precision-sustainable-ag/IRT/README.md

# IRT

## **InfraRed Thermometer Water/Heat Stress Sensing Project - 2019 Summary**  
Rebecca Hartman, Francis Santiago, Patricia Gonzalez-Medina

### Sensors
IRT Sensors from Melexis MLX90614 product line

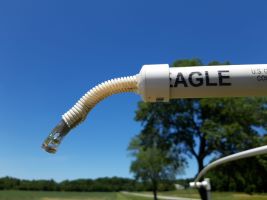
[picture p1: Images/Canopy_Small.jpg]
Canopy Sensor

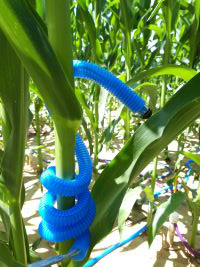
[picture p2: Images/Leaf Sensor_Small.jpg]
Leaf Sensor

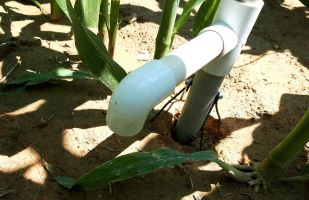
[picture p3: Images/Soil Sensor_Small.jpg]
Soil Sensor


**Canopy** - 90° FOV, **Leaf** - 35° FOV, **Soil** - 35° FOV

### Structure
PVC structure uses rotation instead of translation to adjust height of canopy sensor

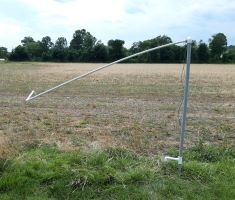
[picture p4: Images/Structure_Small.jpg]
Structure


### Boards
Components: MoteinoMEGA with LoRa transceiver, DS3231 RTC, microSD (Server only), custom PCBs

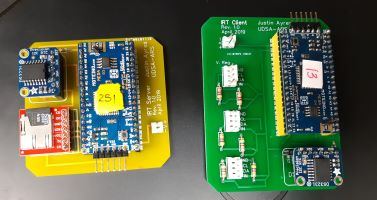
[picture p5: Images/Client Server_Small.jpg]
Client & Server


**Client:** collects data from sensors, saves to Flash, send data to Server
**Server:** receives data from Servers, saves data to microSD

### Power

Components: 12V SLA Batteries, 12V 3W Solar panels, Charge controller, Battery box

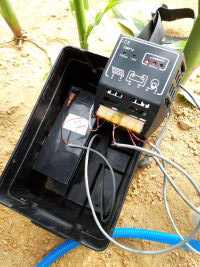
[picture p6: Images/Battery Charger_Small.jpg]
Battery & Controller

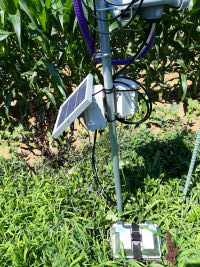
[picture p7: Images/Power Setup_Small.jpg]
Power Setup
