precision-sustainable-ag/IRT/Analysis/Epoxy_Potting Info.docx

- 2 part epoxy we currently have: https://www.jbweld.com/pages/faqs
- A bunch of different epoxies (website from Harry): https://www.electrolube.com/products/thermally-conductive-potting-compounds.html
- These 2 seem like the same glue: http://www.murraypercival.com/product/13948/electrolube-thermally-conductive-epoxy-resins-250g

And

http://www.murraypercival.com/product/13408/er2183-epoxy-resin-pack-thermal-conductivity-250g-black
