precision-sustainable-ag/IRT/Analysis/General Project Ideas.docx

- This guy used these IRT sensors outdoors and had to waterproof them:

https://blog.stevemarple.co.uk/2013/05/cloud-detector-first-data.html

- This is a cable gland like he used, and others have used:

https://www.google.com/search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

- Another application of cable glands/these sensors:

https://sciencedocbox.com/Weather/73594155-Arduino-weather-station-and-ascom-observing-conditions.html
