precision-sustainable-ag/IRT/Images/Client.jpg

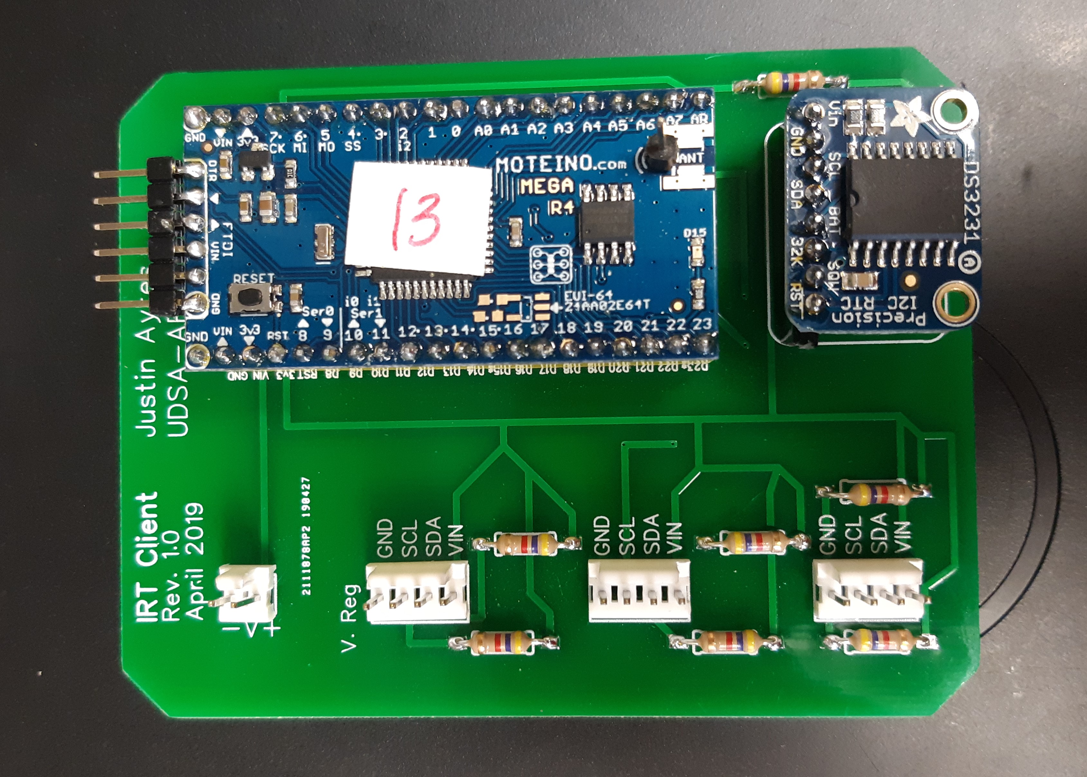
Images/Client.jpg
