precision-sustainable-ag/IRT/Images/Melexis IRT.jpg

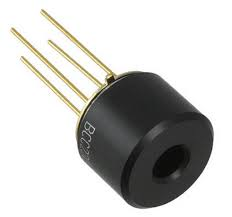
Images/Melexis IRT.jpg
