precision-sustainable-ag/IRT/Images/Server.jpg

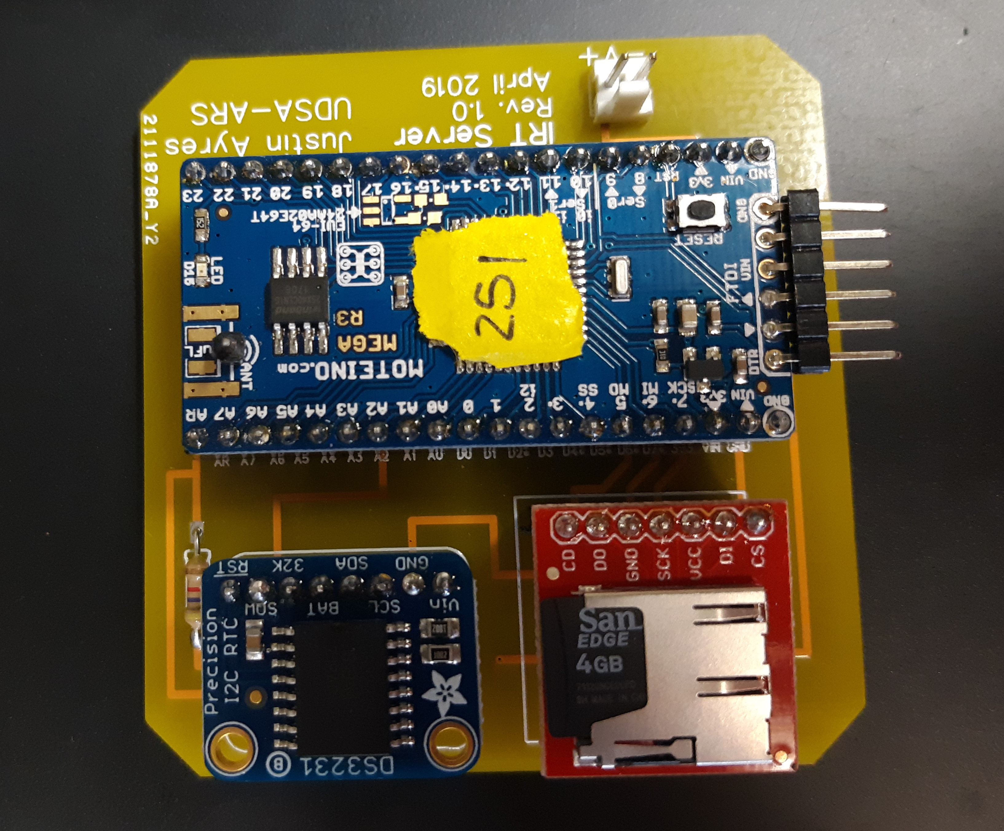
Images/Server.jpg
