precision-sustainable-ag/IRT/Analysis/NC Parts and Cost IRT 2019.xlsx

 |  |  |  |  |  | *Total cost based on materials sent from MD as well (click cell to see formula/ reference)
Component |  |  | Quantity for NC to provide | Individual Cost | Unit | Total Cost | Link
Datalogger
 | Moteino Mega |  | 14 | $20.00 |  | $320.00
 | DS3231 Precision RTC |  | 14 | $12.56 |  | $200.96
 | Coin Cell Battery |  | 14 | $0.39 |  | $6.24
 | SparkFun microSD reader |  | 2 | $3.75 |  | $11.25
 | MicroSD card |  | 3 | $8.40 |  | $25.20
 | Female headers
 |  | 20 pin | 0 | $2.50 | Pack | $20.00 | https://www.adafruit.com/product/4158
 |  | 8 pin | 0 | $2.95 | Pack | $11.80 | https://www.adafruit.com/product/598
 |  | 7 pin | 0 | $2.95 | Pack | $2.21
 | Server PCB |  | 0 | $0.71 | ea | $2.13
 | Client PCB |  | 0 | $0.42 | ea | $5.46
 | 4.7 kΩ resistor |  | 0 | $0.01 | ea | $1.22
 | 11 kΩ resistor |  | 0 | $0.01 | ea | $0.21
 | 30 kΩ resistor |  | 0 | $0.04 | ea | $0.58
 | 4-pin polarized male header |  | 0 | ?
 | 2-pin polarized male header |  | 0 | $0.07 | ea | $1.12
 | 2-pin polarized female connector |  | 0 | ?
Total Datalogger |  |  |  |  |  | $608.38
Canopy Sensor/Structure
 | Gray Sch. 40 Conduit PVC (~7ft, 1.25" dia) |  | 12 | $6.00 | ea | $72.00 | https://www.homedepot.com/p/JM-eagle-1-1-4-in-x-10-ft-PVC-Schedule-40-Conduit-67470/100196693
 | 3/4" PVC |  | 12 | $2.17 | 10 ft piece | $26.04 | https://www.homedepot.com/p/JM-eagle-3-4-in-x-10-ft-480-PSI-Schedule-40-PVC-Plain-End-Pipe-57471/202280935
 | Metal pole |  | 5.5 | $7.62 | pole | $41.91 | https://www.homedepot.com/p/1-in-x-10-ft-Electrical-Metallic-Tubing-EMT-Conduit-550210000/304229415
 | 90 Degree IRT Sensor |  | 0 | $11.23 | ea | $145.99 | https://www.mouser.com/ProductDetail/Melexis/MLX90614ESF-BAA-000-TU
 | PVC tee reducer (1 1/4 x 1 1/4 x 3/4") |  | 0 | $1.97 | ea | $23.64 | https://www.homedepot.com/p/Charlotte-Pipe-1-1-4-in-x-1-1-4-in-x-3-4-in-PVC-Sch-40-S-x-S-x-S-Reducer-Tee-PVC-02400-5350HD/203821667
 | PVC elbow (1 1/4") |  | 0 | $1.54 | ea | $18.48 | https://www.homedepot.com/p/Charlotte-Pipe-1-1-4-in-PVC-Sch-40-90-Degree-S-x-S-Elbow-PVC023001200HD/203812127
 | Zinc-plated round ceiling type screw #8 |  | -0.48 | $6.21 | Pack | $3.23 | https://www.homedepot.com/p/Crown-Bolt-8-Zinc-Plated-Steel-Screw-Hook-25-Piece-per-Pack-803282/204273838
Total Canopy |  |  |  |  |  | $259.29
Snake Sensor/Structure |  |  | 0 | $19.75 | ea | $256.75
Total Snake |  |  |  |  |  | $256.75
Solar Panel Structure
 | Mount |  | 8
 | 12V Solar Panel |  | 8 | $17.00 | ea | $136.00
Total Solar Panel Structure |  |  |  |  |  | $136.00
Misc
 | Enclosure |  | 14 | $10.00 | ea | $140.00
 | 12V Battery Enclosure |  | 8 | $2.08 | ea | $16.64
 | 2c cable (solar panel to charge control) |  | 8 |  | Cables |  | Length = ~10 ft
 | 2c cable (battery to charge control) |  | 8 |  | Cables |  | Length = can be as small as a few inches
 | 2c cable (IRT board to charge control) |  | 14 |  | Cables |  | Length = distance from battery/solar panel to IRT setup
 | Zip ties |  | 28 | $0.02 | ea | $0.59 | https://www.homedepot.com/s/8%2522%2520zip%2520ties?NCNI-5
 | Desiccant packs |  | 28 | $0.11 | ea | $3.08
 | 1 3/4" Flight auger (2" auger will also work) |  | 1 |  | ea | $179.00 | https://www.ams-samplers.com/1-3-4-x-12-flighted-screw-auger-not-for-use-with-electric-hammer-drills.html
 | Self-driving screws |  | 0 | $1.18 | pack | $3.07 | https://www.homedepot.com/p/12-x-1-2-in-Zinc-Plated-Steel-Hex-Head-Slotted-Sheet-Metal-Screw-10-Pack-813001/204275268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
 | Washer (1/4") |  | 0.04 | $2.71 | pack | $2.82 | https://www.homedepot.com/p/Everbilt-1-4-in-Zinc-Plated-Flat-Washer-25-Piece-per-Bag-802304/204276388
 | Washer (3/8") |  | 0.04 | $2.71 | pack | $2.82 | https://www.homedepot.com/p/Everbilt-3-8-in-Zinc-Plated-Flat-Washer-25-Pack-802324/204276362
 | Green wire structure stabilizers |  | -0.02916666667 | $65.71 | pack | $17.80 | https://www.homedepot.com/p/Bond-Manufacturing-36-in-Plant-Prop-456/203327331
 | 12V battery |  | 8 | $10.00 | ea | $80.00
 | Charge Controller |  | 0 | $12.00 | ea | $96.00 | https://www.anself.com/p-h17919-1.html
Total Misc |  |  |  |  |  | $339.31
Overall IRT Cost |  |  |  |  |  | $1599.72
