precision-sustainable-ag/IRT/Analysis/Overall Cost IRT 2019.xlsx

Sheet: Sheet1
Component | Quantity | Unit | Individual Cost | Total Cost | Need (X)
Circuit
Moteino | 1 |  | $17.85 | $17.85
DS3231 Precision RTC | 1 |  | $12.56 | $12.56
Coin Cell Battery | 1 |  | $0.39 | $0.39
SparkFun microSD reader | 1 |  | $3.75 | $3.75
microSD card | 1 |  | $8.40 | $8.40
PCB | 1 |  | $0.80 | $0.80
4.7 kΩ resistor | 9 |  | $0.01 | $0.12
11 kΩ resistor | 1 |  | $0.01 | $0.01
30 kΩ resistor | 1 |  | $0.04 | $0.04
16V 100uF capacitor | 1 |  | $0.09 | $0.09
Diode | 1 |  | $0.13 | $0.13
Push Button | 1 |  | $0.50 | $0.50
LED | 1 |  | $0.08 | $0.08
4-pin polarized male header | 4 |  | $0.10 | $0.40
4-pin polarized female header | 4 |  | $0.21 | $0.82
2-pin polarized male header | 2 |  | $0.07 | $0.14
2-pin polarized female header | 2 |  | $0.10 | $0.21
Total Circuit |  |  |  | $46.29
Sensors and Power
35 degree IRT sensor | 1 |  | $19.00 | $19.00
90 degree IRT sensor | 1 |  | $16.00 | $16.00 |  | https://www.adafruit.com/product/1747
12V battery | 1 |  | $10.00 | $10.00
Total Sensors and Power |  |  |  | $45.00
Canopy Structure
Cable (4 wire) | 10 |  | $0.17 | $1.73
Gray PVC (~7ft, ~1.25" dia) | 0.75 |  | $6.00 | $4.50
Elbow reducer (3/4 to 1") | 1 |  | $1.35 | $1.35
90 degree 3/4" elbow | 4 |  | $0.64 | $2.56
3/4" T PVC | 1 |  | $0.61 | $0.61
3/4" caps | 1 |  | $0.64 | $0.64
3/4" PVC | 7 |  | $0.22 | $1.54
Bolt | 1
Total Canopy Structure |  |  |  | $12.93
Leaf Structure
Cable (4 wire) | 20 |  | $0.17 | $2.55
Plastic tubing (ID 3/8", OD 1/2") | ? |  | ?
12 gauge solid THHN wire (insulated) | 2 |  | $0.32 | $0.64 |  | wire options |  | https://www.homedepot.com/s/12%2520gauge%2520solid%2520copper%2520wire%2520insulated?NCNI-5
Total Leaf Structure |  |  |  | $3.19 |  | non-insulated | .26 per foot | https://www.homedepot.com/p/Southwire-By-the-Foot-12-Gauge-Solid-SD-Bare-Copper-Grounding-Wire-10620390/204724854
 |  |  |  |  |  | insulated | .32 per foot | https://www.homedepot.com/p/Southwire-50-ft-12-Gauge-White-Solid-CU-THHN-Wire-11588117/202316537
Solar Panel Structure
Copper 2 hole straps | 2 |  | $0.24 | $0.48
1" U-bolt | 1 |  | $2.59 | $2.59
Total Solar Panel Structure |  |  |  | $3.07
Misc
Enclosure | 1 |  | $10.00 | $10.00
Battery Enclosure | 1 |  | $2.08 | $2.08
Cable (2 wire) | 11 |  | $0.13 | $1.40
Zip ties | 2 |  | $0.02 | $0.04
Dessicant packs | 2 |  | $0.11 | $0.22
Antenna | 1
Total Misc |  |  |  | $13.74
Overall IRT Cost |  |  |  | $124.22

Sheet: InventoryNeed
 | Total IRTs: | 45 | (just for us, not including 12 for NC)
Component |  | Quantity required for 1 setup | Unit | Total quantity required | Working Quantity | Quantity to order | Individual Cost | Total Cost | Link
Client
 | Moteino Mega | 1 |  | 45 |  | 45 |  | $0.00
 | DS3231 Precision RTC | 1 |  | 45 |  | 45 | $12.56 | $565.20
 | Female headers (2x 20 pin, 1x 8 pin)
 | Coin Cell Battery | 1 |  | 45 |  | 45 | $0.39 | $17.55
 | PCB | 1 |  | 45 |  | 45 |  | $0.00
 | 4.7 kΩ resistor | 7 |  | 315 |  | 315 | $0.01 | $4.09
 | 11 kΩ resistor | 1 |  | 45 |  | 45 | $0.01 | $0.58
 | 30 kΩ resistor | 1 |  | 45 |  | 45 | $0.04 | $1.62
 | 4-pin polarized male header | 3 |  | 135 |  | 135 |  | $0.00
 | 2-pin polarized male header | 2 |  | 90 |  | 90 | $0.07 | $6.30
 | 2-pin polarized female connector | 2 |  | 90 |  | 90 |  | $0.00
Server
 | Moteino Mega | 1 |  | 45 |  | 45 |  | $0.00
 | DS3231 Precision RTC | 1 |  | 45 |  | 45 | $12.56 | $565.20
 | Female headers (2x 20 pin, 1x 8 pin)
 | Coin Cell Battery | 1 |  | 45 |  | 45 | $0.39 | $17.55
 | SparkFun microSD reader | 1 |  | 45 |  | 45 | $3.75 | $168.75
 | microSD card | 1 |  | 45 |  | 45 | $8.40 | $378.00
 | PCB | 1 |  | 45 |  | 45 |  | $0.00
 | 4.7 kΩ resistor | 1 |  | 45 |  | 45 | $0.01 | $0.58
 | 11 kΩ resistor | 1 |  | 45 |  | 45 | $0.01 | $0.58
 | 30 kΩ resistor | 1 |  | 45 |  | 45 | $0.04 | $1.62
 | 4-pin polarized male header | 3 |  | 135 |  | 135 |  | $0.00
 | 2-pin polarized male header | 2 |  | 90 |  | 90 | $0.07 | $6.30
 | 2-pin polarized female connector | 2 |  | 90 |  | 90 |  | $0.00
Total Circuit |  |  |  |  |  |  |  | $595.35
Sensors and Power
 | 35 degree IRT sensor | 2 |  | 90 | 45 | 45 | $17.00 | $765.00 | https://www.mouser.com/ProductDetail/Melexis/MLX90614ESF-BCC-000-SP
 | 90 degree IRT sensor | 1 |  | 45 | 3 | 42 | $11.23 | $471.66 | https://www.mouser.com/ProductDetail/Melexis/MLX90614ESF-BAA-000-TU
 | 12V battery | 1 |  | 26 |  | 26 | $10.00 | $260.00
 | Cable (4c22) | 0.03 | roll | 1.35 | 0.30 | 1.00 | $100.09 | $100.09 | https://www.homedepot.com/p/Southwire-500-ft-22-4-Gray-Stranded-CU-CL3R-Shielded-Security-Cable-57572444/202316269
 | Gray Conduit PVC (~7ft, ~1.25" dia) | 1 | ea | 45 | 45 | 0 | $6.00 | $0.00
 | PVC tee reducer (1 1/4 x 1 1/4 x 3/4") | 1 | ea | 45 | 0 | 45 | $1.97 | $88.65 | https://www.homedepot.com/p/Charlotte-Pipe-1-1-4-in-x-1-1-4-in-x-3-4-in-PVC-Sch-40-S-x-S-x-S-Reducer-Tee-PVC-02400-5350HD/203821667
 | PVC elbow (1 1/4") | 1 | ea | 45 | 0 | 45 | $1.54 | $69.30 | https://www.homedepot.com/p/Charlotte-Pipe-1-1-4-in-PVC-Sch-40-90-Degree-S-x-S-Elbow-PVC023001200HD/203812127
 | 90 degree 3/4" elbow | 1 | ea | 45 | 0 | 45 | $0.64 | $28.80 | https://www.homedepot.com/p/DURA-3-4-in-Schedule-40-PVC-90-Degree-Elbow-C406-007/100347455
 | 3/4" caps | 1 | ea | 45 | 16 | 29 | $0.64 | $18.56 | https://www.homedepot.com/p/Charlotte-Pipe-3-4-in-PVC-Sch-40-Socket-Cap-PVC021160800HD/203811671
 | 3/4" PVC | 1 | 10 ft piece | 45 | 10 | 35 | $2.17 | $75.95 | https://www.homedepot.com/p/JM-eagle-3-4-in-x-10-ft-480-PSI-Schedule-40-PVC-Plain-End-Pipe-57471/202280935
 | Zinc-plated round ceiling type screw #8 | 0.04 | Pack | 1.8 | 0 | 1.8 | $6.21 | $11.18 | https://www.homedepot.com/p/Crown-Bolt-8-Zinc-Plated-Steel-Screw-Hook-25-Piece-per-Pack-803282/204273838
 | Metal pole | 1 | pole | 22.5 | 0 | 22.5 | $7.62 | $171.45 | https://www.homedepot.com/p/1-in-x-10-ft-Electrical-Metallic-Tubing-EMT-Conduit-550210000/304229415
 | Cable (4c22) | 0.02 | roll | 0.900 | 0.36 | 0.54 | $100.09 | $100.09 | https://www.homedepot.com/p/Southwire-500-ft-22-4-Gray-Stranded-CU-CL3R-Shielded-Security-Cable-57572444/202316269
 | Plastic tubing (ID 3/8", OD 1/2") | 0.025 | 10 ft tubing | 1.125 | 0.75 | 1 | $4.93 | $4.93 | https://www.homedepot.com/p/UDP-3-8-in-I-D-x-1-2-in-O-D-x-10-ft-Clear-Vinyl-Tubing-T10006008/304185141
 | 12 gauge solid THHN wire (insulated) | 2.5 | ft | 142.5 | 80 | 1 | $25.97 | $25.97 | https://www.homedepot.com/p/Southwire-100-ft-12-Black-Solid-CU-THHN-Wire-11587384/204868206
 | PVC reducing tee (1 1/4" x 1 1/4" x 1") | 1 |  | 45.00 |  | 47 | $0.85 | $39.95 | https://www.pvcfittingsonline.com/401-168-1-1-4-x-1-1-4-x-1-schedule-40-pvc-reducing-tee.html
 | 1" Elbow | 1 |  | 45.00 | 20 | 42 | $1.14 | $47.88 | https://www.homedepot.com/p/DURA-1-in-Schedule-40-PVC-90-Degree-Elbow-C406-010/100346841
 | 3/4" PVC cap | 1 |  | 45.00 | 25 | 37 | $0.64 | $23.68 | https://www.homedepot.com/p/Charlotte-Pipe-3-4-in-PVC-Sch-40-Socket-Cap-PVC021160800HD/203811671
 | 1" PVC | 0.417 | ft | 18.75 | 23.75 | 0
 | Mount | 1 |  | 45 |  | 45 |  | $0.00
 | Solar Panel | 1 | ea | 45 | 45 | 0 | $17.00
 | Charge Controller | 1 |  | 22.5
 | Enclosure | 1 |  | 45 |  | 45 | $10.00 | $450.00 |  |  | Apparently Home Depot only gave you 6 packs of the Everbilt #12 x 1/2 in. Zinc-Plated Steel Hex-Head Slotted Sheet Metal Screw (10-Pack) instead of the 8 you wanted.
 | Battery Enclosure | 1 |  | 45 |  | 45 | $2.08 | $93.60
 | Cable (2c22) | 11 |  | 495 | 500 |  | $0.13 |  |  |  | Problem is we're not allowed to purchase anything for the time being, so we'll have to use what we have and then order the last 2 packs when we're able to buy stuff again.
 | Zip ties | 2 |  | 90 | 90 | 0 | $0.02 | $0.00 | https://www.homedepot.com/s/8%2522%2520zip%2520ties?NCNI-5
 | Desiccant packs | 2 |  | 90 | 90 | 0 | $0.11 | $0.00 | * Have to find/dry out
 | Antenna | 1 |  | 45 |  | 45 |  | $0.00
 | 1 3/4" Flight auger | 1 |  | 1 | 0 | 1 |  | $179.00 | https://www.ams-samplers.com/1-3-4-x-12-flighted-screw-auger-not-for-use-with-electric-hammer-drills.html
 | #12 x 1/2" Self-driving screws | 0.2 | pack | 4.5 | 0 | 4.5 | $1.18 | $5.31 | https://www.homedepot.com/p/12-x-1-2-in-Zinc-Plated-Steel-Hex-Head-Slotted-Sheet-Metal-Screw-10-Pack-813001/204275268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
 | Washer (1/4") | 0.08 | pack | 3.6 |  | 3.6 | $2.71 | $9.76 | https://www.homedepot.com/p/Everbilt-1-4-in-Zinc-Plated-Flat-Washer-25-Piece-per-Bag-802304/204276388
 | Washer (3/8") | 0.08 | pack | 3.6 | 3.3 | 0.3 | $2.71 | $0.87 | https://www.homedepot.com/p/Everbilt-3-8-in-Zinc-Plated-Flat-Washer-25-Pack-802324/204276362
 | 36" Plant prop | 0.02083333333 | pack | 0.9375 | 0 | 0.9375 | $65.71 | $65.71 | https://www.homedepot.com/p/Bond-Manufacturing-36-in-Plant-Prop-456/203327331
Total Misc |  |  |  |  |  |  |  | $722.60 | or quick connect: | https://www.ams-samplers.com/1-3-4-x-12-qc-flighted-screw-auger-not-for-use-with-electric-hammer-drills.html
Overall IRT Cost |  |  |  |  |  |  |  | $3621.09

Sheet: North Carolina List
 | Clients |  | 13 | 1 Extra of each
 | Servers |  | 3
Component |  |  | Quantity required for 1 setup | Unit | Total quantity required | Working Quantity | Quantity to order | Individual Cost | Total Cost | Link
Client
 | Moteino Mega |  | 1 |  | 13 |  | 13 | $20.00 | $260.00
 | DS3231 Precision RTC |  | 1 |  | 13 |  | 13 | $12.56 | $163.28
 | Female headers |  |  |  | 0 |  | 0
 |  | 20 pin | 0.4 | Pack | 5.2 |  | 5.2 | $2.50 | $13.00 | https://www.adafruit.com/product/4158
 |  | 8 pin | 0.25 |  | 3.25 |  | 3.25 | $2.95 | $9.59 | https://www.adafruit.com/product/598
 | Coin Cell Battery |  | 1 |  | 13 |  | 13 | $0.39 | $5.07
 | PCB |  | 1 |  | 13 |  | 13 |  | $0.00
 | 4.7 kΩ resistor |  | 7 |  | 91 |  | 91 | $0.01 | $1.18
 | 11 kΩ resistor |  | 1 |  | 13 |  | 13 | $0.01 | $0.17
 | 30 kΩ resistor |  | 1 |  | 13 |  | 13 | $0.04 | $0.47
 | 4-pin polarized male header |  | 3 |  | 39 |  | 39 |  | $0.00
 | 2-pin polarized male header |  | 1 |  | 13 |  | 13 | $0.07 | $0.91
 | 2-pin polarized female connector |  | 1 |  | 13 |  | 13 |  | $0.00
Total Client |  |  |  |  |  |  |  |  | $453.67
Server
 | Moteino Mega |  | 1 |  | 3 |  | 3 | $20.00 | $60.00
 | DS3231 Precision RTC |  | 1 |  | 3 |  | 3 | $12.56 | $37.68
 | Coin Cell Battery |  | 1 |  | 3 |  | 3 | $0.39 | $1.17
 | SparkFun microSD reader |  | 1 |  | 3 |  | 3 | $3.75 | $11.25
 | microSD card |  | 1 |  | 3 |  | 3 | $8.40 | $25.20
 | Female headers
 |  | 20 pin | 0.4 | Pack | 2.0 |  | 2 | $2.50 | $5.00
 |  | 8 pin | 0.25 | Pack | 0.75 |  | 0.75 | $2.95 | $2.21
 |  | 7 pin | 0.25 | Pack | 0.75 |  | 0.75 | $2.95 | $2.21
 | PCB |  | 1 |  | 3 |  | 3
 | 4.7 kΩ resistor |  | 1 |  | 3 |  | 3 | $0.01 | $0.04
 | 11 kΩ resistor |  | 1 |  | 3 |  | 3 | $0.01 | $0.04
 | 30 kΩ resistor |  | 1 |  | 3 |  | 3 | $0.04 | $0.11
 | 2-pin polarized male header |  | 1 |  | 3 |  | 3 | $0.07 | $0.21
 | 2-pin polarized female connector |  | 1 |  | 3 |  | 3 |  | $0.00
Total Server |  |  |  |  |  |  |  |  | $145.12
Total Circuit |  |  |  |  |  |  |  |  | $598.79
Sensors
 | 35 degree IRT sensor (soil, snake) |  | 2 |  | 26 | 0 | 26 | $17.00 | $442.00 | https://www.mouser.com/ProductDetail/Melexis/MLX90614ESF-BCC-000-SP
 | 90 degree IRT sensor (canopy) |  | 1 |  | 13 | 0 | 13 | $11.23 | $145.99 | https://www.mouser.com/ProductDetail/Melexis/MLX90614ESF-BAA-000-TU
Total Sensors and Power |  |  |  |  |  |  |  |  | $587.99
Canopy Structure
 | Cable (4c22) |  | 0.03 | roll | 0.39 | 0.00 | 1.00 | $100.09 | $100.09 | https://www.homedepot.com/p/Southwire-500-ft-22-4-Gray-Stranded-CU-CL3R-Shielded-Security-Cable-57572444/202316269
 | Gray Conduit PVC (~7ft, ~1.25" dia) |  | 1 | ea | 13 | 0 | 13 | $6.00 | $78.00
 | PVC tee reducer (1 1/4 x 1 1/4 x 3/4") |  | 1 | ea | 13 | 0 | 13 | $1.97 | $25.61 | https://www.homedepot.com/p/Charlotte-Pipe-1-1-4-in-x-1-1-4-in-x-3-4-in-PVC-Sch-40-S-x-S-x-S-Reducer-Tee-PVC-02400-5350HD/203821667
 | PVC elbow (1 1/4") |  | 1 | ea | 13 | 0 | 13 | $1.54 | $20.02 | https://www.homedepot.com/p/Charlotte-Pipe-1-1-4-in-PVC-Sch-40-90-Degree-S-x-S-Elbow-PVC023001200HD/203812127
 | 90 degree 3/4" elbow |  | 1 | ea | 13 | 0 | 13 | $0.64 | $8.32 | https://www.homedepot.com/p/DURA-3-4-in-Schedule-40-PVC-90-Degree-Elbow-C406-007/100347455
 | 3/4" caps |  | 1 | ea | 13 | 0 | 13 | $0.64 | $8.32 | https://www.homedepot.com/p/Charlotte-Pipe-3-4-in-PVC-Sch-40-Socket-Cap-PVC021160800HD/203811671
 | 3/4" PVC |  | 1 | 10 ft piece | 13 | 0 | 13 | $2.17 | $28.21 | https://www.homedepot.com/p/JM-eagle-3-4-in-x-10-ft-480-PSI-Schedule-40-PVC-Plain-End-Pipe-57471/202280935
 | Zinc-plated round ceiling type screw #8 |  | 0.04 | Pack | 0.52 | 0 | 0.52 | $6.21 | $3.23 | https://www.homedepot.com/p/Crown-Bolt-8-Zinc-Plated-Steel-Screw-Hook-25-Piece-per-Pack-803282/204273838
 | Metal pole |  | 1 | pole | 6.5 | 0 | 6.5 | $7.62 | $49.53 | https://www.homedepot.com/p/1-in-x-10-ft-Electrical-Metallic-Tubing-EMT-Conduit-550210000/304229415
Total Canopy Structure |  |  |  |  |  |  |  |  | $321.33 | https://www.homedepot.com/p/Crown-Bolt-1-4-in-x-28-Zinc-Grade-5-SAE-Hex-Nut-25-Pack-26890/203436106
Leaf Structure
 | Cable (4c22) |  | 0.02 | roll | 0.260 | 0.26 | 0 | $100.09 | $0.00 | *Already accounted for
 | Plastic tubing (ID 3/8", OD 1/2") |  | 0.02 | 10 ft tubing | 0.2166666667 | 0.75 | 1 | $4.93 | $4.93 | https://www.homedepot.com/p/UDP-3-8-in-I-D-x-1-2-in-O-D-x-10-ft-Clear-Vinyl-Tubing-T10006008/304185141
 | 12 gauge solid THHN wire (insulated) |  | 2.5 | ft | 62.5 | 80 | 1 | $25.97 | $25.97 | https://www.homedepot.com/p/Southwire-100-ft-12-Black-Solid-CU-THHN-Wire-11587384/204868206
Total Leaf Structure |  |  |  |  |  |  |  |  | $30.90
Soil Sensor Structure
 | PVC reducing tee (1 1/4" x 1 1/4" x 1") |  | 1 |  | 13.00 | 0 | 47 | $0.85 | $39.95 | https://www.pvcfittingsonline.com/401-168-1-1-4-x-1-1-4-x-1-schedule-40-pvc-reducing-tee.html
 | 1" Elbow |  | 1 |  | 13.00 | 0 | 30 | $1.14 | $34.20 | https://www.homedepot.com/p/DURA-1-in-Schedule-40-PVC-90-Degree-Elbow-C406-010/100346841
 | 3/4" PVC cap |  | 1 |  | 13.00 | 0 | 30 | $0.64 | $19.20 | https://www.homedepot.com/p/Charlotte-Pipe-3-4-in-PVC-Sch-40-Socket-Cap-PVC021160800HD/203811671
 | 1" PVC |  | 0.417 | ft | 5.42 | 0.00 | 0
Total Soil Structure |  |  |  |  |  |  |  |  | $93.35
Solar Panel Structure
 | Mount |  | 1 |  | 13 | 0 | 13 |  | $0.00
 | Solar Panel |  | 1 | ea | 13 | 0 | 13 | $17.00
Total Solar Panel Structure |  |  |  |  |  |  |  |  | $0.00
Misc
 | Enclosure |  | 1 |  | 13 |  | 13 | $10.00 | $130.00
 | Battery Enclosure |  | 1 |  | 13 |  | 13 | $2.08 | $27.04
 | Cable (2 wire) |  | 11 | ft | 143 |  |  | $0.13
 | Zip ties |  | 2 |  | 26 |  | 26 | $0.02 | $0.55 | https://www.homedepot.com/s/8%2522%2520zip%2520ties?NCNI-5
 | Desiccant packs |  | 2 |  | 26 |  | 26 | $0.11 | $2.86
 | 1 3/4" Flight auger |  | 1 |  | 1 |  | 1 |  | $179.00 | https://www.ams-samplers.com/1-3-4-x-12-flighted-screw-auger-not-for-use-with-electric-hammer-drills.html
 | Self-driving screws |  | 0.2 | pack | 1.3 |  | 1.3 | $1.18 | $1.53 | https://www.homedepot.com/p/12-x-1-2-in-Zinc-Plated-Steel-Hex-Head-Slotted-Sheet-Metal-Screw-10-Pack-813001/204275268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
 | Washer (1/4") |  | 0.08 | pack | 1.04 |  | 1.04 | $2.71 | $2.82 | https://www.homedepot.com/p/Everbilt-1-4-in-Zinc-Plated-Flat-Washer-25-Piece-per-Bag-802304/204276388
 | Washer (3/8") |  | 0.08 | pack | 1.0 |  | 1.0 | $2.71 | $2.82 | https://www.homedepot.com/p/Everbilt-3-8-in-Zinc-Plated-Flat-Washer-25-Pack-802324/204276362
 | 36" Plant prop |  | 0.02083333333 | pack | 0.2708333333 |  | 0.2708333333 | $65.71 | $65.71 | https://www.homedepot.com/p/Bond-Manufacturing-36-in-Plant-Prop-456/203327331
 | 12V battery |  |  |  | 8 |  | 8 | $10.00 | $80.00
 | Charge Controller |  |  |  | 8
Total Misc |  |  |  |  |  |  |  |  | $339.45
Overall IRT Cost |  |  |  |  |  |  |  |  | $1971.81

Sheet: Copy of North Carolina List
Component |  |  | Quantity for NC to provide | Individual Cost | Unit | Total Cost | Link
Datalogger
 | Moteino Mega |  | 14 | $20.00 |  | $320.00
 | DS3231 Precision RTC |  | 14 | $12.56 |  | $200.96
 | SparkFun microSD reader |  | 2 | $3.75 |  | $11.25
 | microSD card |  | 3 | $8.40 |  | $25.20
 | Female headers |  |  |  |  | $0.00
 |  | 20 pin | 7.6 | $2.50 | Pack | $20.00 | https://www.adafruit.com/product/4158
 |  | 8 pin | 3.5 | $2.95 | Pack | $11.80 | https://www.adafruit.com/product/598
 |  | 7 pin | 0.5 | $2.95 | Pack | $2.21
 | Coin Cell Battery |  | 15 | $0.39 |  | $6.24
 | Server PCB |  | 0 | $0.71 | ea | $2.13
 | Client PCB |  | 0 | $0.42 | ea | $5.46
 | 4.7 kΩ resistor |  | 87 | $0.01 | ea | $1.22
 | 11 kΩ resistor |  | 9 | $0.01 | ea | $0.21
 | 30 kΩ resistor |  | 15 | $0.04 | ea | $0.58
 | 4-pin polarized male header |  | 36 | ?
 | 2-pin polarized male header |  | 14 | $0.07 | ea | $1.12
 | 2-pin polarized female connector |  | 0 | ?
Total Datalogger |  |  |  |  |  | $608.38
Canopy Sensor/Structure
 | 90 Degree IRT Sensor |  | 0 | $11.23 | ea | $145.99 | https://www.mouser.com/ProductDetail/Melexis/MLX90614ESF-BAA-000-TU
 | Gray Sch. 40 Conduit PVC (~7ft, 1.25" dia) |  | 12 | $6.00 | ea | $72.00 | https://www.homedepot.com/p/JM-eagle-1-1-4-in-x-10-ft-PVC-Schedule-40-Conduit-67470/100196693
 | PVC tee reducer (1 1/4 x 1 1/4 x 3/4") |  | 0 | $1.97 | ea | $23.64 | https://www.homedepot.com/p/Charlotte-Pipe-1-1-4-in-x-1-1-4-in-x-3-4-in-PVC-Sch-40-S-x-S-x-S-Reducer-Tee-PVC-02400-5350HD/203821667
 | PVC elbow (1 1/4") |  | 0 | $1.54 | ea | $18.48 | https://www.homedepot.com/p/Charlotte-Pipe-1-1-4-in-PVC-Sch-40-90-Degree-S-x-S-Elbow-PVC023001200HD/203812127
 | 3/4" PVC |  | 12 | $2.17 | 10 ft piece | $26.04 | https://www.homedepot.com/p/JM-eagle-3-4-in-x-10-ft-480-PSI-Schedule-40-PVC-Plain-End-Pipe-57471/202280935
 | Zinc-plated round ceiling type screw #8 |  | -0.48 | $6.21 | Pack | $3.23 | https://www.homedepot.com/p/Crown-Bolt-8-Zinc-Plated-Steel-Screw-Hook-25-Piece-per-Pack-803282/204273838
 | Metal pole |  | 5.5 | $7.62 | pole | $41.91 | https://www.homedepot.com/p/1-in-x-10-ft-Electrical-Metallic-Tubing-EMT-Conduit-550210000/304229415
Total Canopy |  |  |  |  |  | $331.29 | https://www.homedepot.com/p/Crown-Bolt-1-4-in-x-28-Zinc-Grade-5-SAE-Hex-Nut-25-Pack-26890/203436106
Snake Sensor/Structure |  |  | 0 | $19.75 | ea | $256.75
Total Snake |  |  |  |  |  | $256.75
Soil Sensor/Structure |  |  | 0 | $19.63 | ea | $255.19
Total Soil |  |  |  |  |  | $255.19
Solar Panel Structure
 | Mount |  | 8 |  |  | $0.00
 | 12V Solar Panel |  | 8 | $17.00 | ea | $136.00
Total Solar Panel Structure |  |  |  |  |  | $136.00
Misc
 | Enclosure |  | 14 | $10.00 | ea | $140.00
 | Battery Enclosure |  | 8 | $2.08 | ea | $16.64
 | 2c cable (solar panel to charge control) |  | 80 | $0.13 | ft | $10.19
 | 2c cable (battery to charge control) |  | 8 | $0.13 | ft | $1.02
 | 2c cable (IRT board to charge control) |  | 8 |  | Cables |  | Length = distance from battery/solar panel to IRT setup
 | Zip ties |  | 28 | $0.02 | ea | $0.59 | https://www.homedepot.com/s/8%2522%2520zip%2520ties?NCNI-5
 | Desiccant packs |  | 28 | $0.11 | ea | $3.08
 | 1 3/4" Flight auger (2" auger will also work) |  | 1 |  | ea | $179.00 | https://www.ams-samplers.com/1-3-4-x-12-flighted-screw-auger-not-for-use-with-electric-hammer-drills.html
 | Self-driving screws |  | 0 | $1.18 | pack | $3.07 | https://www.homedepot.com/p/12-x-1-2-in-Zinc-Plated-Steel-Hex-Head-Slotted-Sheet-Metal-Screw-10-Pack-813001/204275268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
 | Washer (1/4") |  | 0.04 | $2.71 | pack | $2.82 | https://www.homedepot.com/p/Everbilt-1-4-in-Zinc-Plated-Flat-Washer-25-Piece-per-Bag-802304/204276388
 | Washer (3/8") |  | 0.04 | $2.71 | pack | $2.82 | https://www.homedepot.com/p/Everbilt-3-8-in-Zinc-Plated-Flat-Washer-25-Pack-802324/204276362
 | Green wire structure stabilizers |  | -0.02916666667 | $65.71 | pack | $17.80 | https://www.homedepot.com/p/Bond-Manufacturing-36-in-Plant-Prop-456/203327331
 | 12V battery |  | 8 | $10.00 | ea | $80.00
 | Charge Controller |  | 0 | $12.00 | ea | $96.00 | https://www.anself.com/p-h17919-1.html
Total Misc |  |  |  |  |  | $350.52
Overall IRT Cost |  |  |  |  |  | $1938.12

Sheet: Order Sheet
Part | Quantity | Unit Price | Total Price | Link
Electrical tape | 1 | 5.49 | $5.49 | https://www.homedepot.com/p/Commercial-Electric-7-mil-Vinyl-Electrical-Tape-Black-10-Pack-30002653/202799051
Cable (4c22) | 2.00 | $100.09 | $200.18 | https://www.homedepot.com/p/Southwire-500-ft-22-4-Gray-Stranded-CU-CL3R-Shielded-Security-Cable-57572444/202316269
PVC tee reducer (1 1/4 x 1 1/4 x 3/4") | 47 | $0.85 | $39.95 | https://www.pvcfittingsonline.com/401-167-1-1-4-x-1-1-4-x-3-4-schedule-40-pvc-reducing-tee.html
PVC elbow 90 degree (1 1/4") | 45 | $0.65 | $29.25 | https://www.pvcfittingsonline.com/1-1-4-sch-40-pvc-90-elbow-soc-406-012.html
PVC elbow 90 degree (3/4") | 32 | $0.21 | $6.72 | https://www.pvcfittingsonline.com/406-007-3-4-schedule-40-pvc-90-ell.html
3/4" caps | 66 | $0.20 | $13.20 | https://www.pvcfittingsonline.com/447-007-3-4-schedule-40-pvc-cap.html
3/4" PVC | 35 | $2.17 | $75.95 | https://www.homedepot.com/p/JM-eagle-3-4-in-x-10-ft-480-PSI-Schedule-40-PVC-Plain-End-Pipe-57471/202280935
Zinc-plated round ceiling type screw #8 | 1.8 | $6.21 | $11.18 | https://www.homedepot.com/p/Crown-Bolt-8-Zinc-Plated-Steel-Screw-Hook-25-Piece-per-Pack-803282/204273838
Metal pole | 22.5 | $7.62 | $171.45 | https://www.homedepot.com/p/1-in-x-10-ft-Electrical-Metallic-Tubing-EMT-Conduit-550210000/304229415
Plastic tubing (ID 3/8", OD 1/2") | 1 | $4.93 | $4.93 | https://www.homedepot.com/p/UDP-3-8-in-I-D-x-1-2-in-O-D-x-10-ft-Clear-Vinyl-Tubing-T10006008/304185141
12 gauge solid THHN wire (insulated) | 1 | $25.97 | $25.97 | https://www.homedepot.com/p/Southwire-100-ft-12-Black-Solid-CU-THHN-Wire-11587384/204868206
PVC reducing tee (1 1/4" x 1 1/4" x 1") | 47 | $0.85 | $39.95 | https://www.pvcfittingsonline.com/401-168-1-1-4-x-1-1-4-x-1-schedule-40-pvc-reducing-tee.html
PVC elbow 90 degree (1") | 42 | $0.38 | $15.96 | https://www.pvcfittingsonline.com/1-sch-40-pvc-90-elbow-soc-406-010.html
Charge Controller | 28.5 |  | $0.00
Battery Enclosure | 45 | $2.08 | $93.60
Self-driving screws | 4.5 | $1.18 | $5.31 | https://www.homedepot.com/p/12-x-1-2-in-Zinc-Plated-Steel-Hex-Head-Slotted-Sheet-Metal-Screw-10-Pack-813001/204275268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
Washer (1/4") | 3.6 | $2.71 | $9.76 | https://www.homedepot.com/p/Everbilt-1-4-in-Zinc-Plated-Flat-Washer-25-Piece-per-Bag-802304/204276388
Washer (3/8") | 1 | $2.71 | $2.71 | https://www.homedepot.com/p/Everbilt-3-8-in-Zinc-Plated-Flat-Washer-25-Pack-802324/204276362
36" Plant prop | 0.9375 | $65.71 | $61.60 | https://www.homedepot.com/p/Bond-Manufacturing-36-in-Plant-Prop-456/203327331
44" Plant prop | 1 | 41.85 | 41.85 | https://www.homedepot.com/p/Bond-Manufacturing-44-in-Plant-Prop-457/203327332
Total |  |  | $813.16
Questions
- How much should we send NC (for convenience bc we're ordering it and we have access to it (plant props, right size screws, etc)
- Which charge controller? (Find one want to try)
- Will also need wire to run across field to connect both setups in microplot to each other and the solar panel/ battery. Need to order or some around somewhere? (Some extras in box in back of pole barn)
- Have enough 12V batteries? (Need 20+6) (FSP needs 20 and CCSP needs 12-14, so 32-34 total)

Sheet: Stakes
Item |  | Price per inch | # Stakes | Size per stake (in) | Cost per stake | Cost per structure (2 stakes per structure) | Link
1/8" x 48" Plain Steel Cold Rolled Round Rod |  | 0.052 | 3 | 16 | 0.840 | 1.68 | https://www.homedepot.com/p/Everbilt-1-8-in-x-48-in-Plain-Steel-Cold-Rolled-Round-Rod-801567/204273942
 | - Perk: sturdier
44" Plant Prop |  | 0.042 | 2 | 20 | 0.830 | 1.66 | https://www.homedepot.com/p/Bond-Manufacturing-44-in-Plant-Prop-457/203327332
36" Plant Prop |  | 0.037 | 2 | 16 | 0.595 | 1.19 | https://www.homedepot.com/p/Bond-Manufacturing-36-in-Plant-Prop-456/203327331
18" Plant Prop |  | 0.074 | 1 | 16 | 1.180 | 2.36 | https://www.homedepot.com/p/Vigoro-18-in-Plant-Prop-611872/100584404
